pypewpew/hardware-europython2019/testing/before.jpg

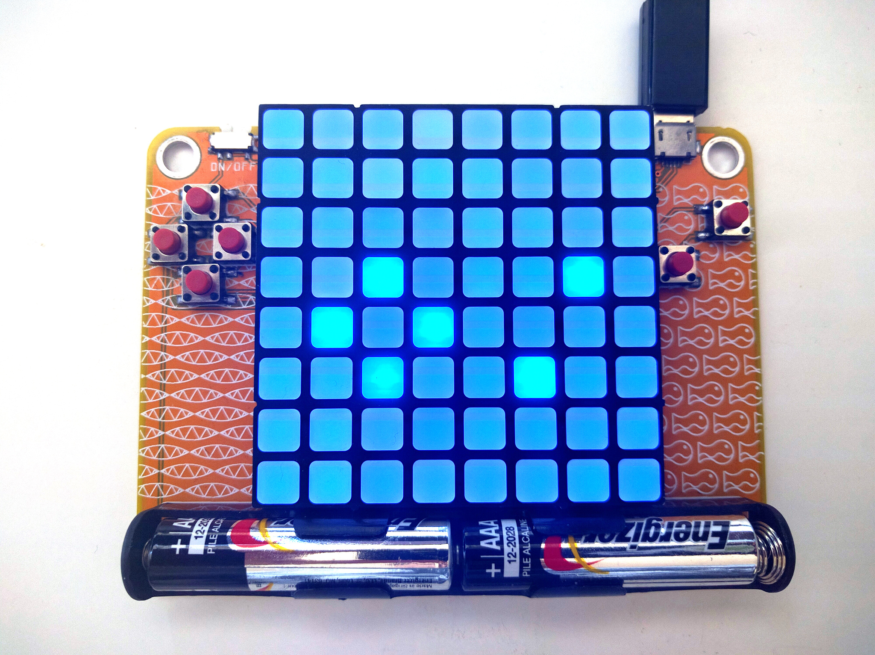
testing/before.jpg
