pypewpew/hardware-europython2019/testing/testing-rig.jpg

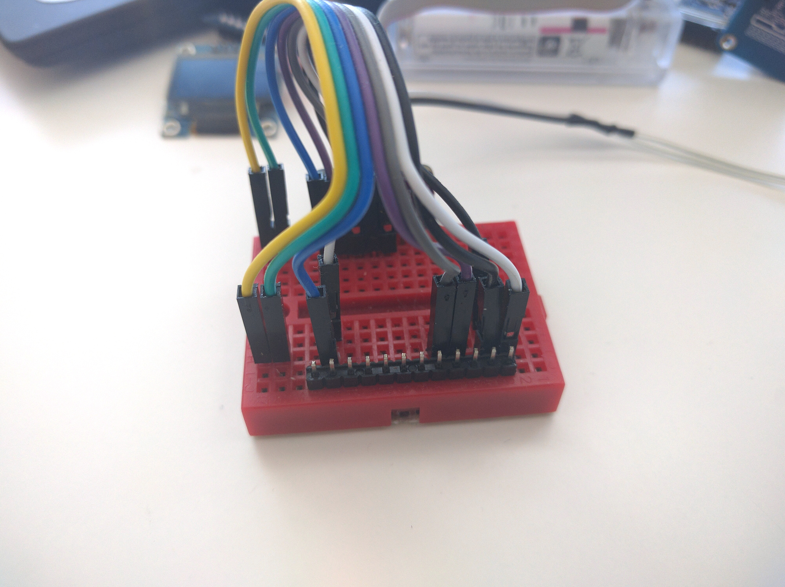
testing/testing-rig.jpg
