pypewpew/hardware-europython2019/pewpew-10.4_schem.pdf

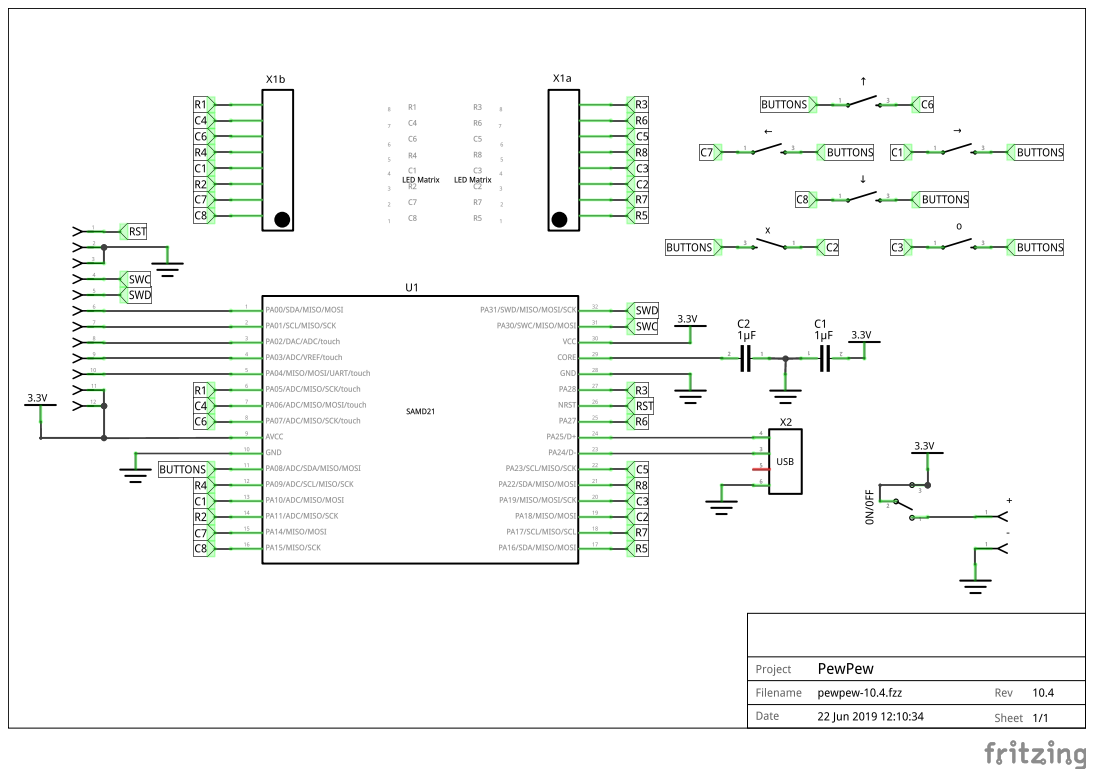
[picture p3: page 1]
