pypewpew/hardware-europython2019/(list of files, drawings)

Other design files:
pewpew-10.4.fzz
