pypewpew/hardware-europython2019/testing/after.jpg

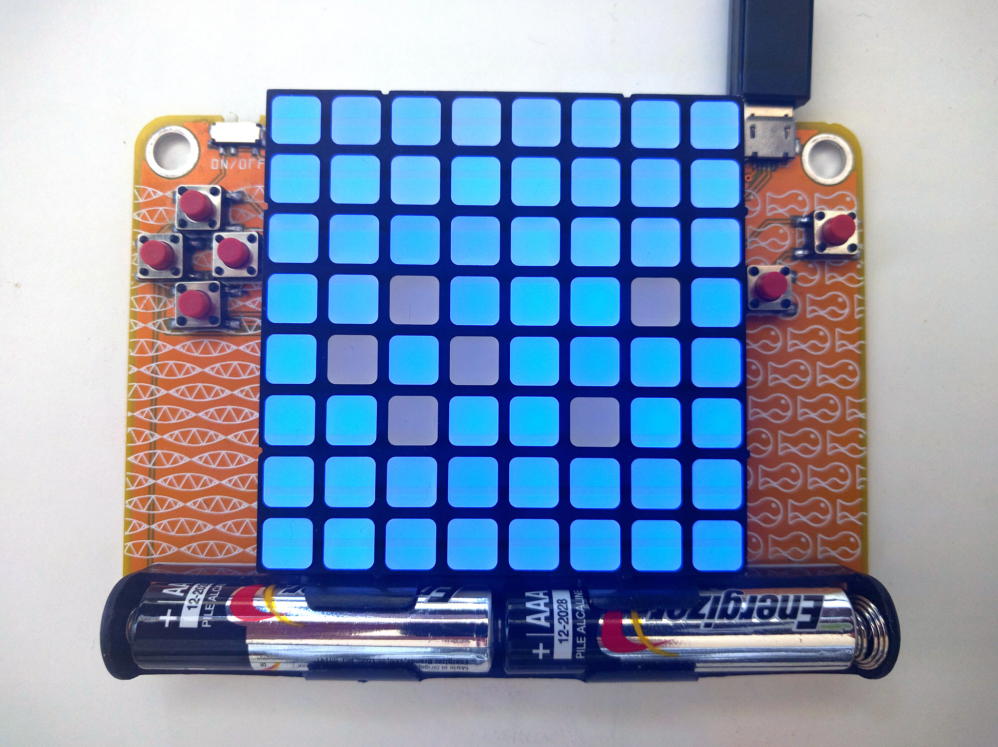
testing/after.jpg
